UAlberta-EcoCar/Auxiliaries-Board/E-P-099-R3.0.brd

## EAGLE design E-P-099-R3.0.brd (2018-06-12)

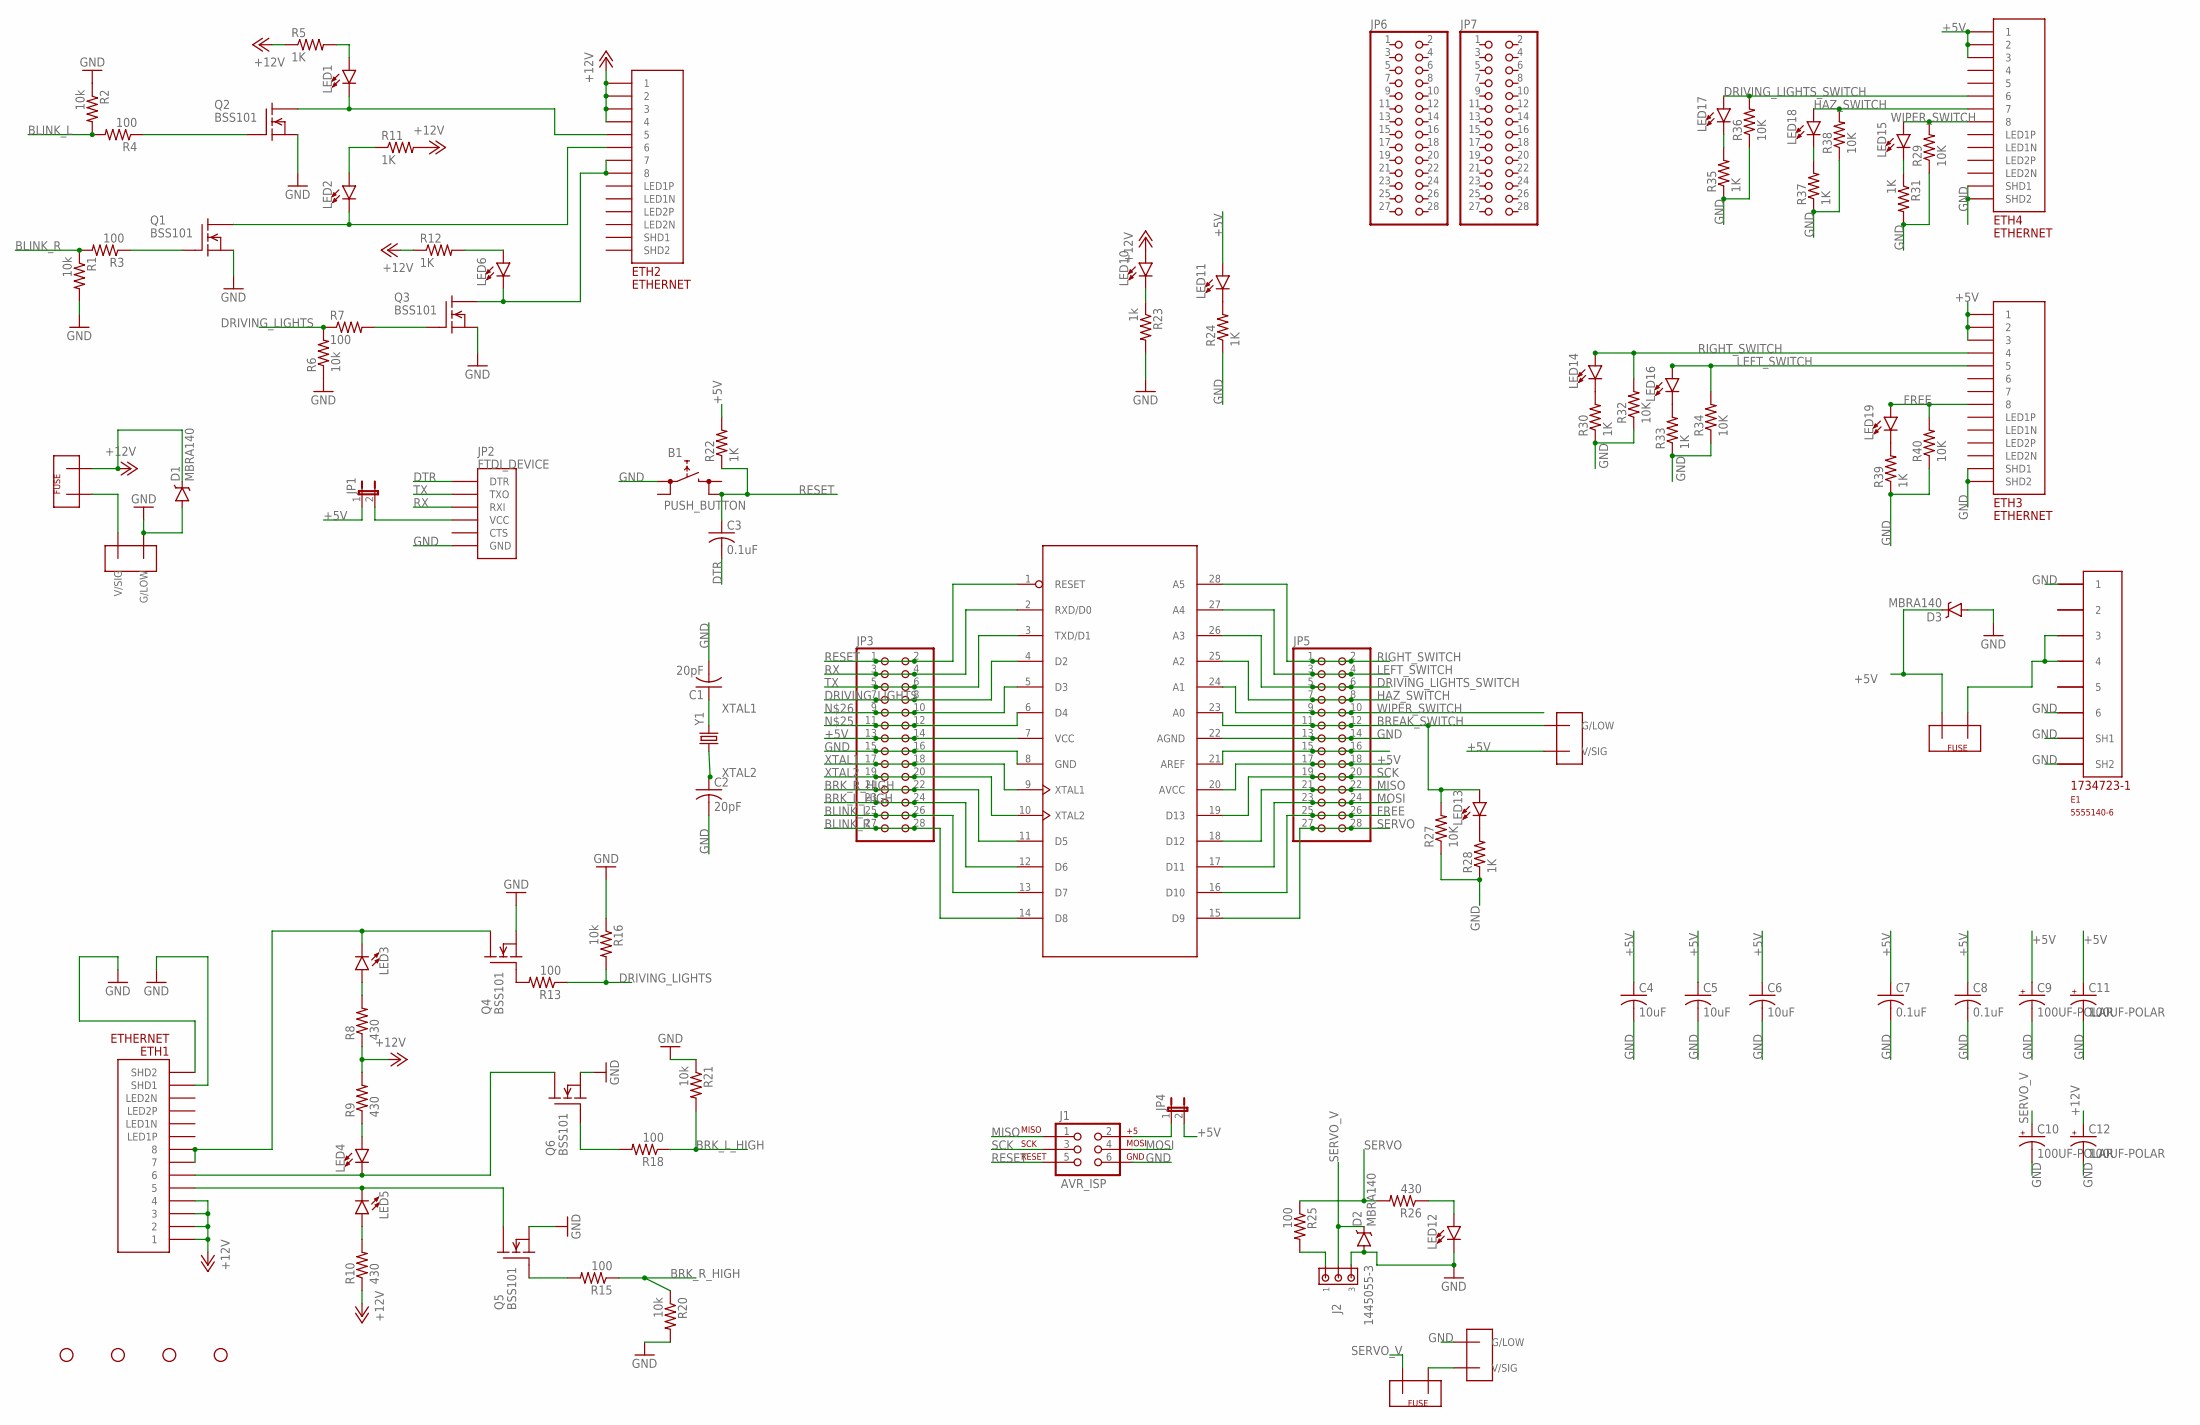
[picture p1: schematic E-P-099-R3.0.sch]

Parts:
AT1: ATMEGA328; DIP28-0.3IN
B1: PUSH_BUTTON; PUSHBUTTON
C1, C2: 20pF; C0805
C3, C7, C8: 0.1uF; C0805
C4, C5, C6: 10uF; C0805
C9, C10, C11, C12: 100UF-POLAR; EEU-FR1H101
D1, D2, D3: MBRA140; SMA-DIODE
E1: 5555140-6; 1734723-1_RJ11
ETH1, ETH2, ETH3, ETH4: ETHERNET; A122645-ND
F1, F2, F3: FUSEMINI-BLADE; MINI-BLADE-FUSE
J1: AVR_ISP; 2X3
J2: 1445055-3
JP1, JP4: JP1E; JP1
JP2: FTDI_DEVICE; FTDI_DEVICE_SIDE
JP3, JP5, JP6, JP7: PINHD-2X14; 2X14
LED1, LED2, LED3, LED4, LED5, LED6, LED10, LED11, LED12, LED13, LED14, LED15, LED16, LED17, LED18, LED19: LED0603; LED-0603
Q1, Q2, Q3, Q4, Q5, Q6: BSS101; TO92
R1, R2, R6, R16, R20, R21: 10k; 0805
R3, R4, R7, R13, R15, R18, R25: 100; 0805
R5, R11, R12, R22, R24, R28, R30, R31, R33, R35, R37, R39: 1K; 0805
R8, R9, R10, R26: 430; 0805
R23: 1k; 0805
R27, R29, R32, R34, R36, R38, R40: 10K; R0805
STANDOFF1, STANDOFF2, STANDOFF3, STANDOFF4: STAND-OFF
TE1, TE3: TE770966; 2X1-MATE-N-LOCK
TE2: SERVO_PWR; 2X1-MATE-N-LOCK
Y1: CRYSTALHC49US; HC49US

Connections:
+5V: AT1.7 (VCC), AT1.20 (AVCC), C4.1, C5.1, C6.1, C7.1, C8.1, C9.P (+), C11.P (+), D3.C, ETH3.P$1 (1), ETH3.P$2 (2), ETH3.P$3 (3), ETH4.P$1 (1), ETH4.P$2 (2), ETH4.P$3 (3), F3.OUT, JP1.1, JP3.13, JP3.14, JP4.2, JP5.17, JP5.18, LED11.A, R22.2, TE3.CIRCUIT1 (V/SIG)
+12V: C12.P (+), D1.C, ETH1.P$1 (1), ETH1.P$2 (2), ETH1.P$3 (3), ETH1.P$4 (4), ETH2.P$1 (1), ETH2.P$2 (2), ETH2.P$3 (3), ETH2.P$4 (4), F1.OUT, LED10.A, R5.1, R8.1, R9.2, R10.1, R11.2, R12.1
BLINK_L: AT1.13 (D7), JP3.25, JP3.26, R2.2, R4.2
BLINK_R: AT1.14 (D8), JP3.27, JP3.28, R1.1, R3.2
BREAK_SWITCH: AT1.23 (A0), JP5.11, JP5.12, LED13.A, R27.2, TE3.CIRCUIT2 (G/LOW)
BRK_L_HIGH: AT1.12 (D6), JP3.23, JP3.24, R18.1, R21.2
BRK_R_HIGH: AT1.11 (D5), JP3.21, JP3.22, R15.1, R20.1
DRIVING_LIGHTS: AT1.4 (D2), JP3.7, JP3.8, R6.2, R7.1, R13.1, R16.2
DRIVING_LIGHTS_SWITCH: AT1.26 (A3), ETH4.P$6 (6), JP5.5, JP5.6, LED17.A, R36.2
DTR: C3.2, JP2.P$1 (DTR)
FREE: AT1.16 (D10), ETH3.P$8 (8), JP5.25, JP5.26, LED19.A, R40.2
GND: AT1.8 (GND), AT1.22 (AGND), B1.L1 (L), C1.2, C2.2, C4.2, C5.2, C6.2, C7.2, C8.2, C9.G (-), C10.G (-), C11.G (-), C12.G (-), D1.A, D2.A, D3.A, E1.1, E1.6, E1.SH1, E1.SH2, ETH1.P$13 (SHD1), ETH1.P$14 (SHD2), ETH3.P$13 (SHD1), ETH3.P$14 (SHD2), ETH4.P$13 (SHD1), ETH4.P$14 (SHD2), J1.6, J2.3, JP2.P$6 (GND), JP3.15, JP3.16, JP5.13, JP5.14, LED12.C, Q1.1 (S), Q2.1 (S), Q3.1 (S), Q4.1 (S), Q5.1 (S), Q6.1 (S), R1.2, R2.1, R6.1, R16.1, R20.2, R21.1, R23.2, R24.1, R27.1, R28.1, R29.1, R30.1, R31.2, R32.1, R33.1, R34.1, R35.1, R36.1, R37.1, R38.1, R39.1, R40.1, TE1.CIRCUIT2 (G/LOW), TE2.CIRCUIT2 (G/LOW)
HAZ_SWITCH: AT1.25 (A2), ETH4.P$7 (7), JP5.7, JP5.8, LED18.A, R38.2
LEFT_SWITCH: AT1.27 (A4), ETH3.P$5 (5), JP5.3, JP5.4, LED16.A, R34.2
MISO: AT1.18 (D12), J1.1, JP5.21, JP5.22
MOSI: AT1.17 (D11), J1.4, JP5.23, JP5.24
unnamed: LED14.C, R30.2
unnamed: LED17.C, R35.2
unnamed: LED16.C, R33.2
unnamed: ETH1.P$7 (7), ETH1.P$8 (8), LED3.C, Q4.3 (D)
unnamed: ETH1.P$6 (6), LED4.C, Q6.3 (D)
unnamed: E1.3, E1.4, F3.IN
unnamed: ETH1.P$5 (5), LED5.C, Q5.3 (D)
unnamed: Q4.2 (G), R13.2
unnamed: JP1.2, JP2.P$4 (VCC)
unnamed: LED19.C, R39.2
unnamed: LED13.C, R28.2
unnamed: LED12.A, R26.1
unnamed: J2.1, R25.2
unnamed: Q5.2 (G), R15.2
unnamed: Q6.2 (G), R18.2
unnamed: LED10.C, R23.1
unnamed: Q2.2 (G), R4.1
unnamed: LED5.A, R10.2
unnamed: LED11.C, R24.2
unnamed: ETH2.P$7 (7), ETH2.P$8 (8), LED6.C, Q3.3 (D)
unnamed: ETH2.P$6 (6), LED2.C, Q1.3 (D)
unnamed: ETH2.P$5 (5), LED1.C, Q2.3 (D)
unnamed: LED4.A, R9.1
unnamed: AT1.6 (D4), JP3.11, JP3.12
unnamed: AT1.5 (D3), JP3.9, JP3.10
unnamed: LED3.A, R8.2
unnamed: LED15.C, R31.1
unnamed: F2.IN, TE2.CIRCUIT1 (V/SIG)
unnamed: LED1.A, R5.2
unnamed: Q1.2 (G), R3.1
unnamed: LED2.A, R11.1
unnamed: Q3.2 (G), R7.2
unnamed: LED6.A, R12.2
unnamed: J1.2, JP4.1
unnamed: LED18.C, R37.2
unnamed: F1.IN, TE1.CIRCUIT1 (V/SIG)
unnamed: AT1.21 (AREF), JP5.15, JP5.16
RESET: AT1.1 (RESET), B1.R2 (R), C3.1, J1.5, JP3.1, JP3.2, R22.1
RIGHT_SWITCH: AT1.28 (A5), ETH3.P$4 (4), JP5.1, JP5.2, LED14.A, R32.2
RX: AT1.2 (RXD/D0), JP2.P$3 (RXI), JP3.3, JP3.4
SCK: AT1.19 (D13), J1.3, JP5.19, JP5.20
SERVO: AT1.15 (D9), JP5.27, JP5.28, R25.1, R26.2
SERVO_V: C10.P (+), D2.C, F2.OUT, J2.2
TX: AT1.3 (TXD/D1), JP2.P$2 (TXO), JP3.5, JP3.6
WIPER_SWITCH: AT1.24 (A1), ETH4.P$8 (8), JP5.9, JP5.10, LED15.A, R29.2
XTAL1: AT1.9 (XTAL1), C1.1, JP3.17, JP3.18, Y1.2
XTAL2: AT1.10 (XTAL2), C2.1, JP3.19, JP3.20, Y1.1

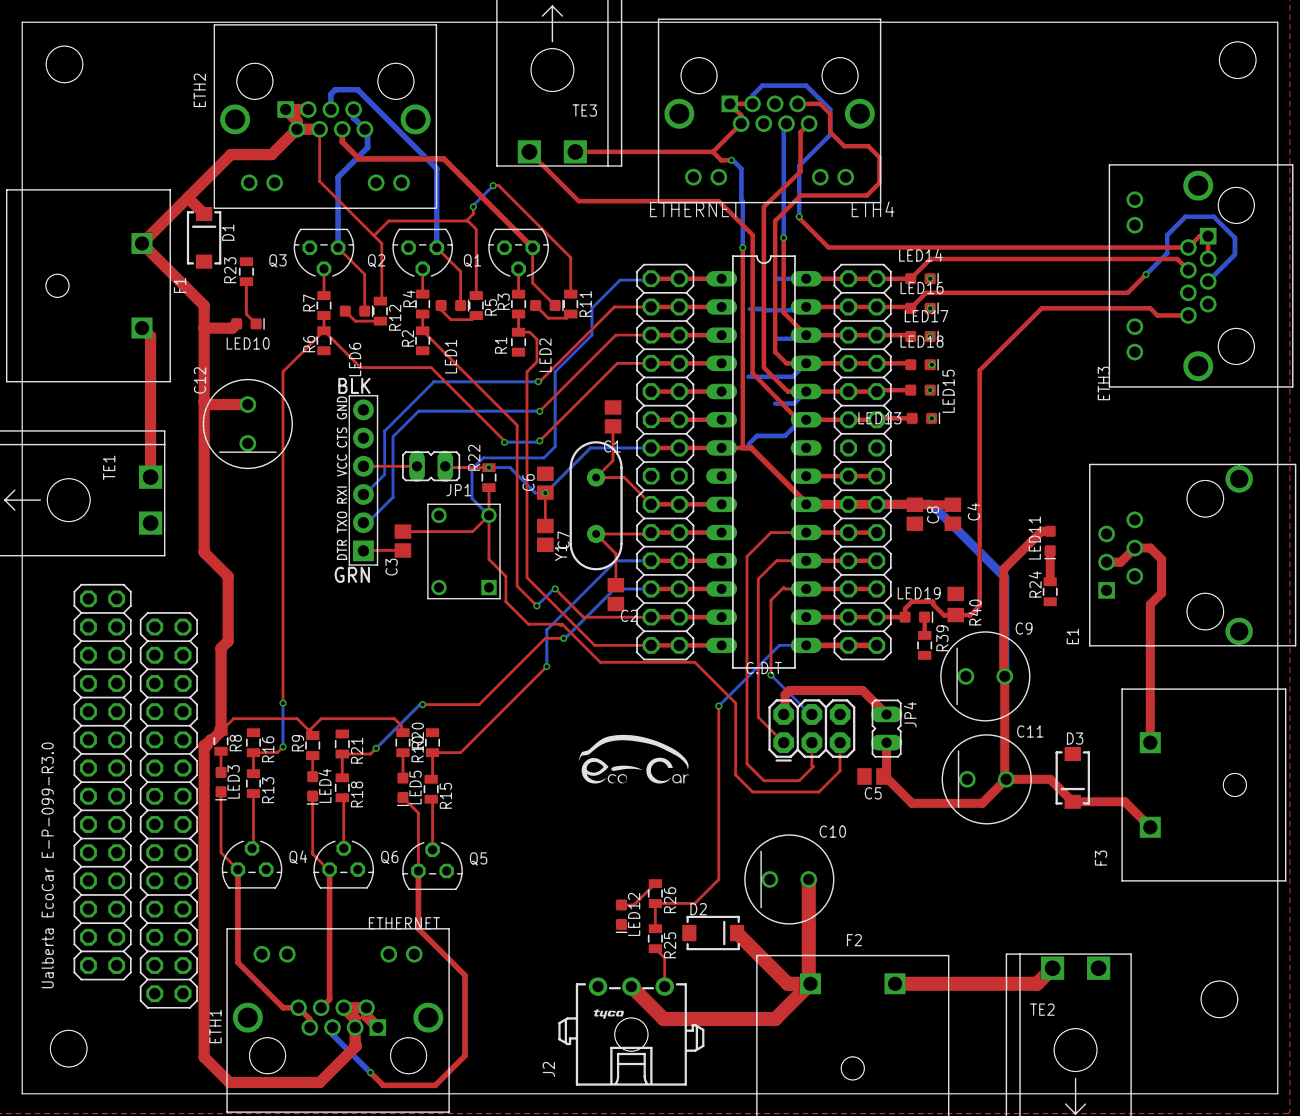
[picture p2: board E-P-099-R3.0.brd from above]

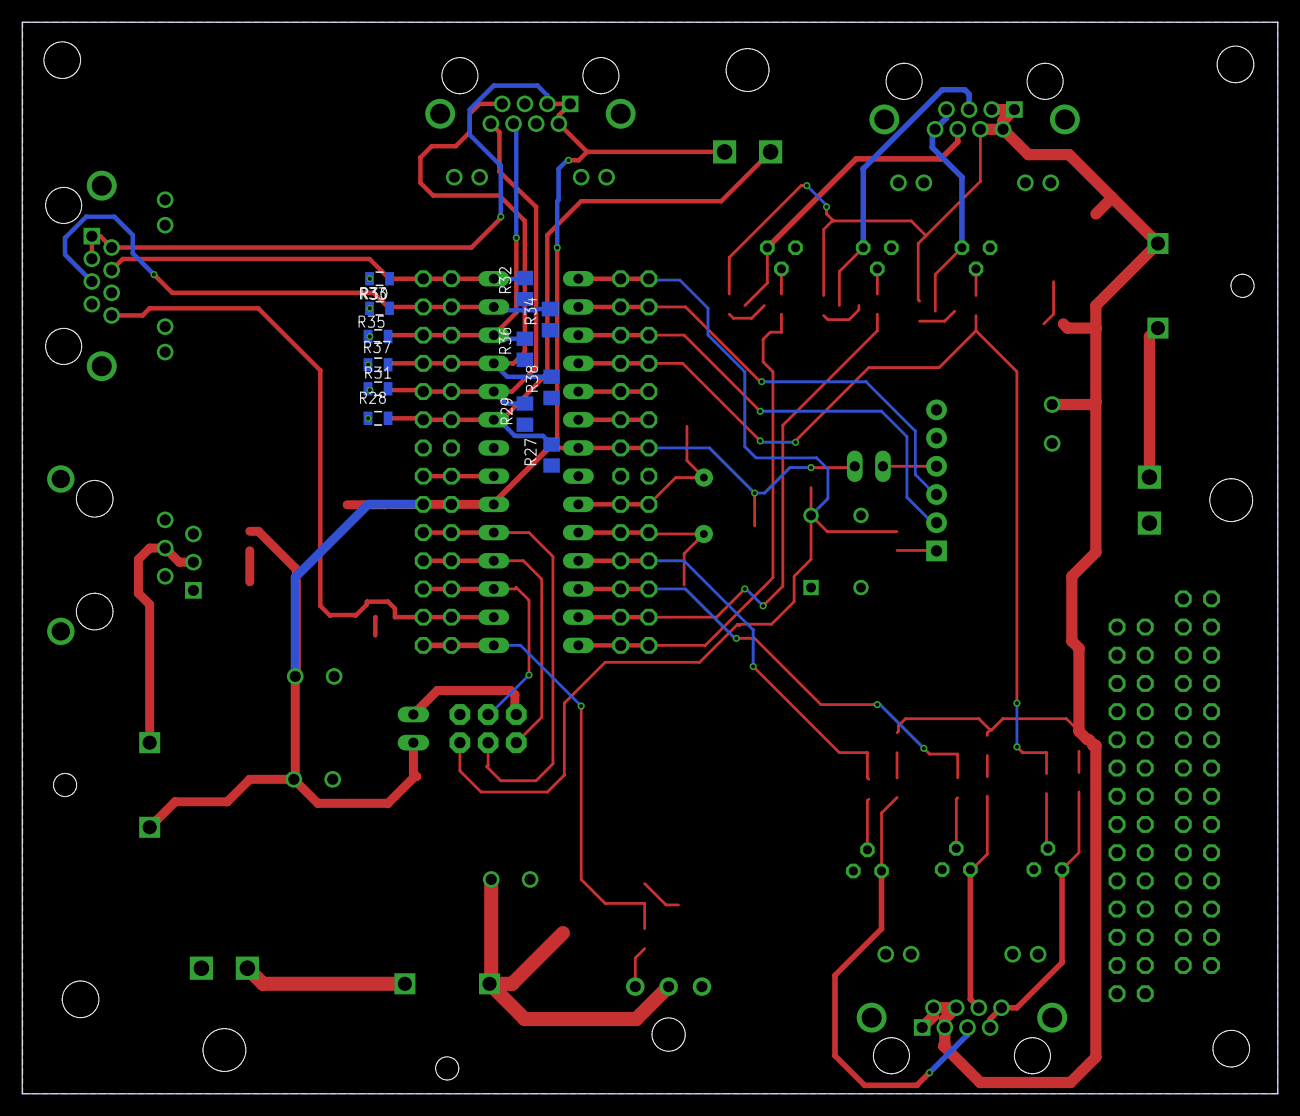
[picture p3: board E-P-099-R3.0.brd from below]

Board: 2 copper layers, 113.1 x 96.5 mm, 101 parts (12 on the bottom side), 63 nets.
