UAlberta-EcoCar/Auxiliaries-Board/Horn Board/Horn Board Rev 1.brd

## EAGLE design Horn Board/Horn Board Rev 1.brd (2017-12-05)

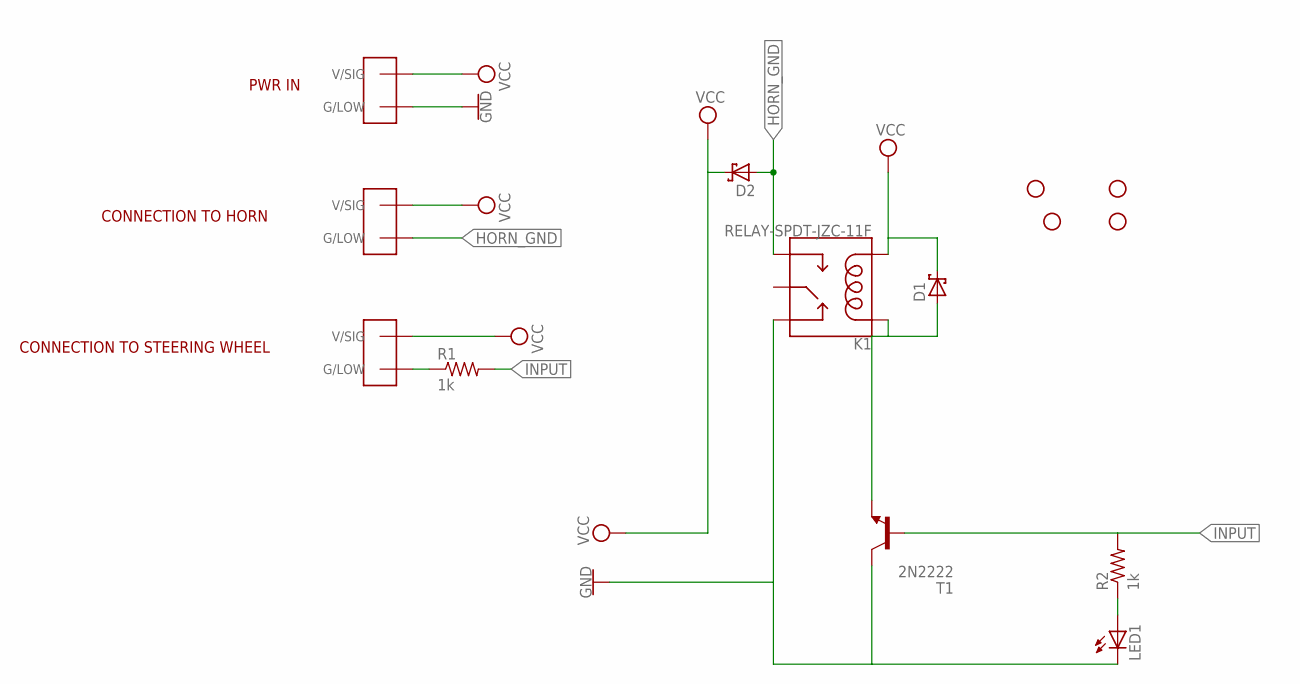
[picture p4: schematic Horn Board Rev 1.sch]

Parts:
D1, D2: SCHOTTKY-DIODEAG; AG
H1, H2, H3, H4: STAND-OFF
K1: RELAY-SPDT-JZC-11F; RELAY-JZC
LED1: LED; SMARTLED-TTW
R1, R2: 1k; 0204V
T1: 2N2222; TO92-EBC-OVAL
U$1, U$2, U$8: TE770966; 2X1-MATE-N-LOCK

Connections:
GND: K1.2 (NC), LED1.C@1 (C), T1.C, U$8.CIRCUIT2 (G/LOW)
HORN_GND: D2.A, K1.3 (NO), U$1.CIRCUIT2 (G/LOW)
INPUT: R1.2, R2.2, T1.B
unnamed: R1.1, U$2.CIRCUIT2 (G/LOW)
unnamed: D1.A, K1.5 (COIL1), T1.E
unnamed: LED1.A@1 (A), R2.1
VCC: D1.C, D2.C, K1.1 (COIL2), U$1.CIRCUIT1 (V/SIG), U$2.CIRCUIT1 (V/SIG), U$8.CIRCUIT1 (V/SIG)

Notes on the sheet:
PWR IN
CONNECTION TO HORN
CONNECTION TO STEERING WHEEL

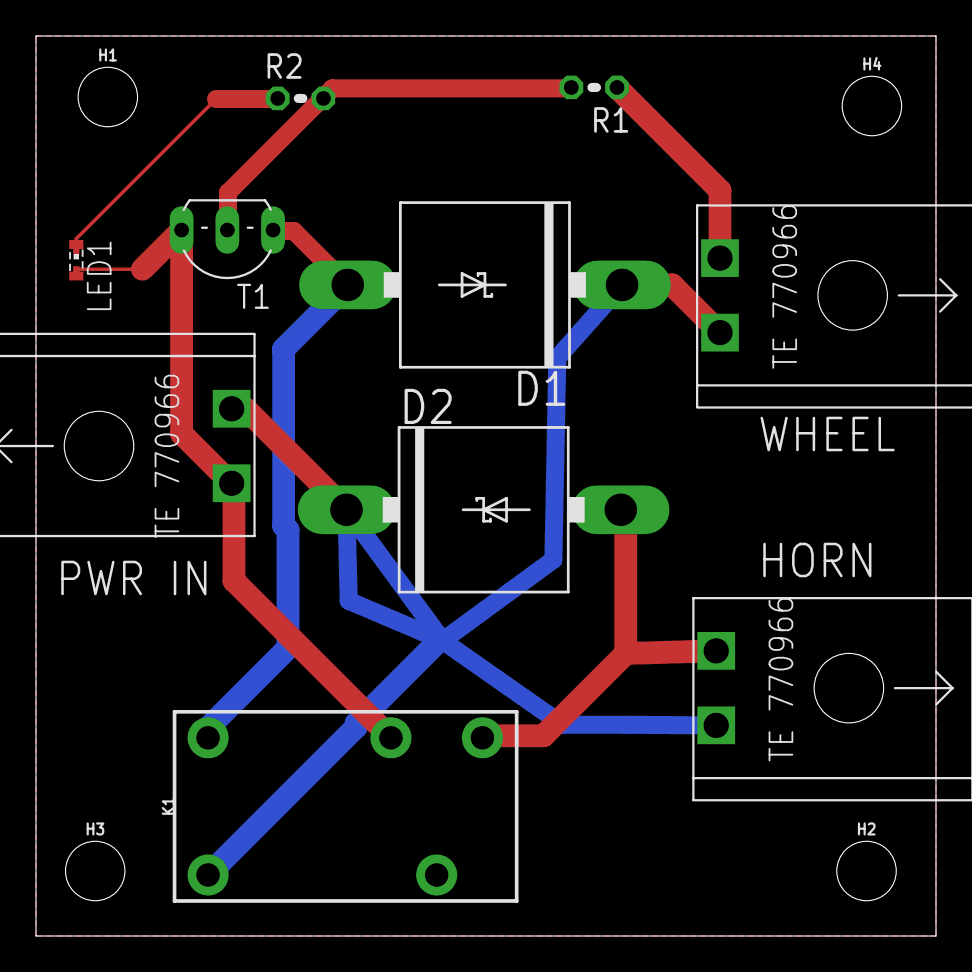
[picture p5: board Horn Board Rev 1.brd from above]

Board: 2 copper layers, 50.0 x 50.0 mm, 14 parts (0 on the bottom side), 7 nets.
