UAlberta-EcoCar/Auxiliaries-Board/E-P-099-R2.7.brd

## EAGLE design E-P-099-R2.7.brd (2017-09-17)

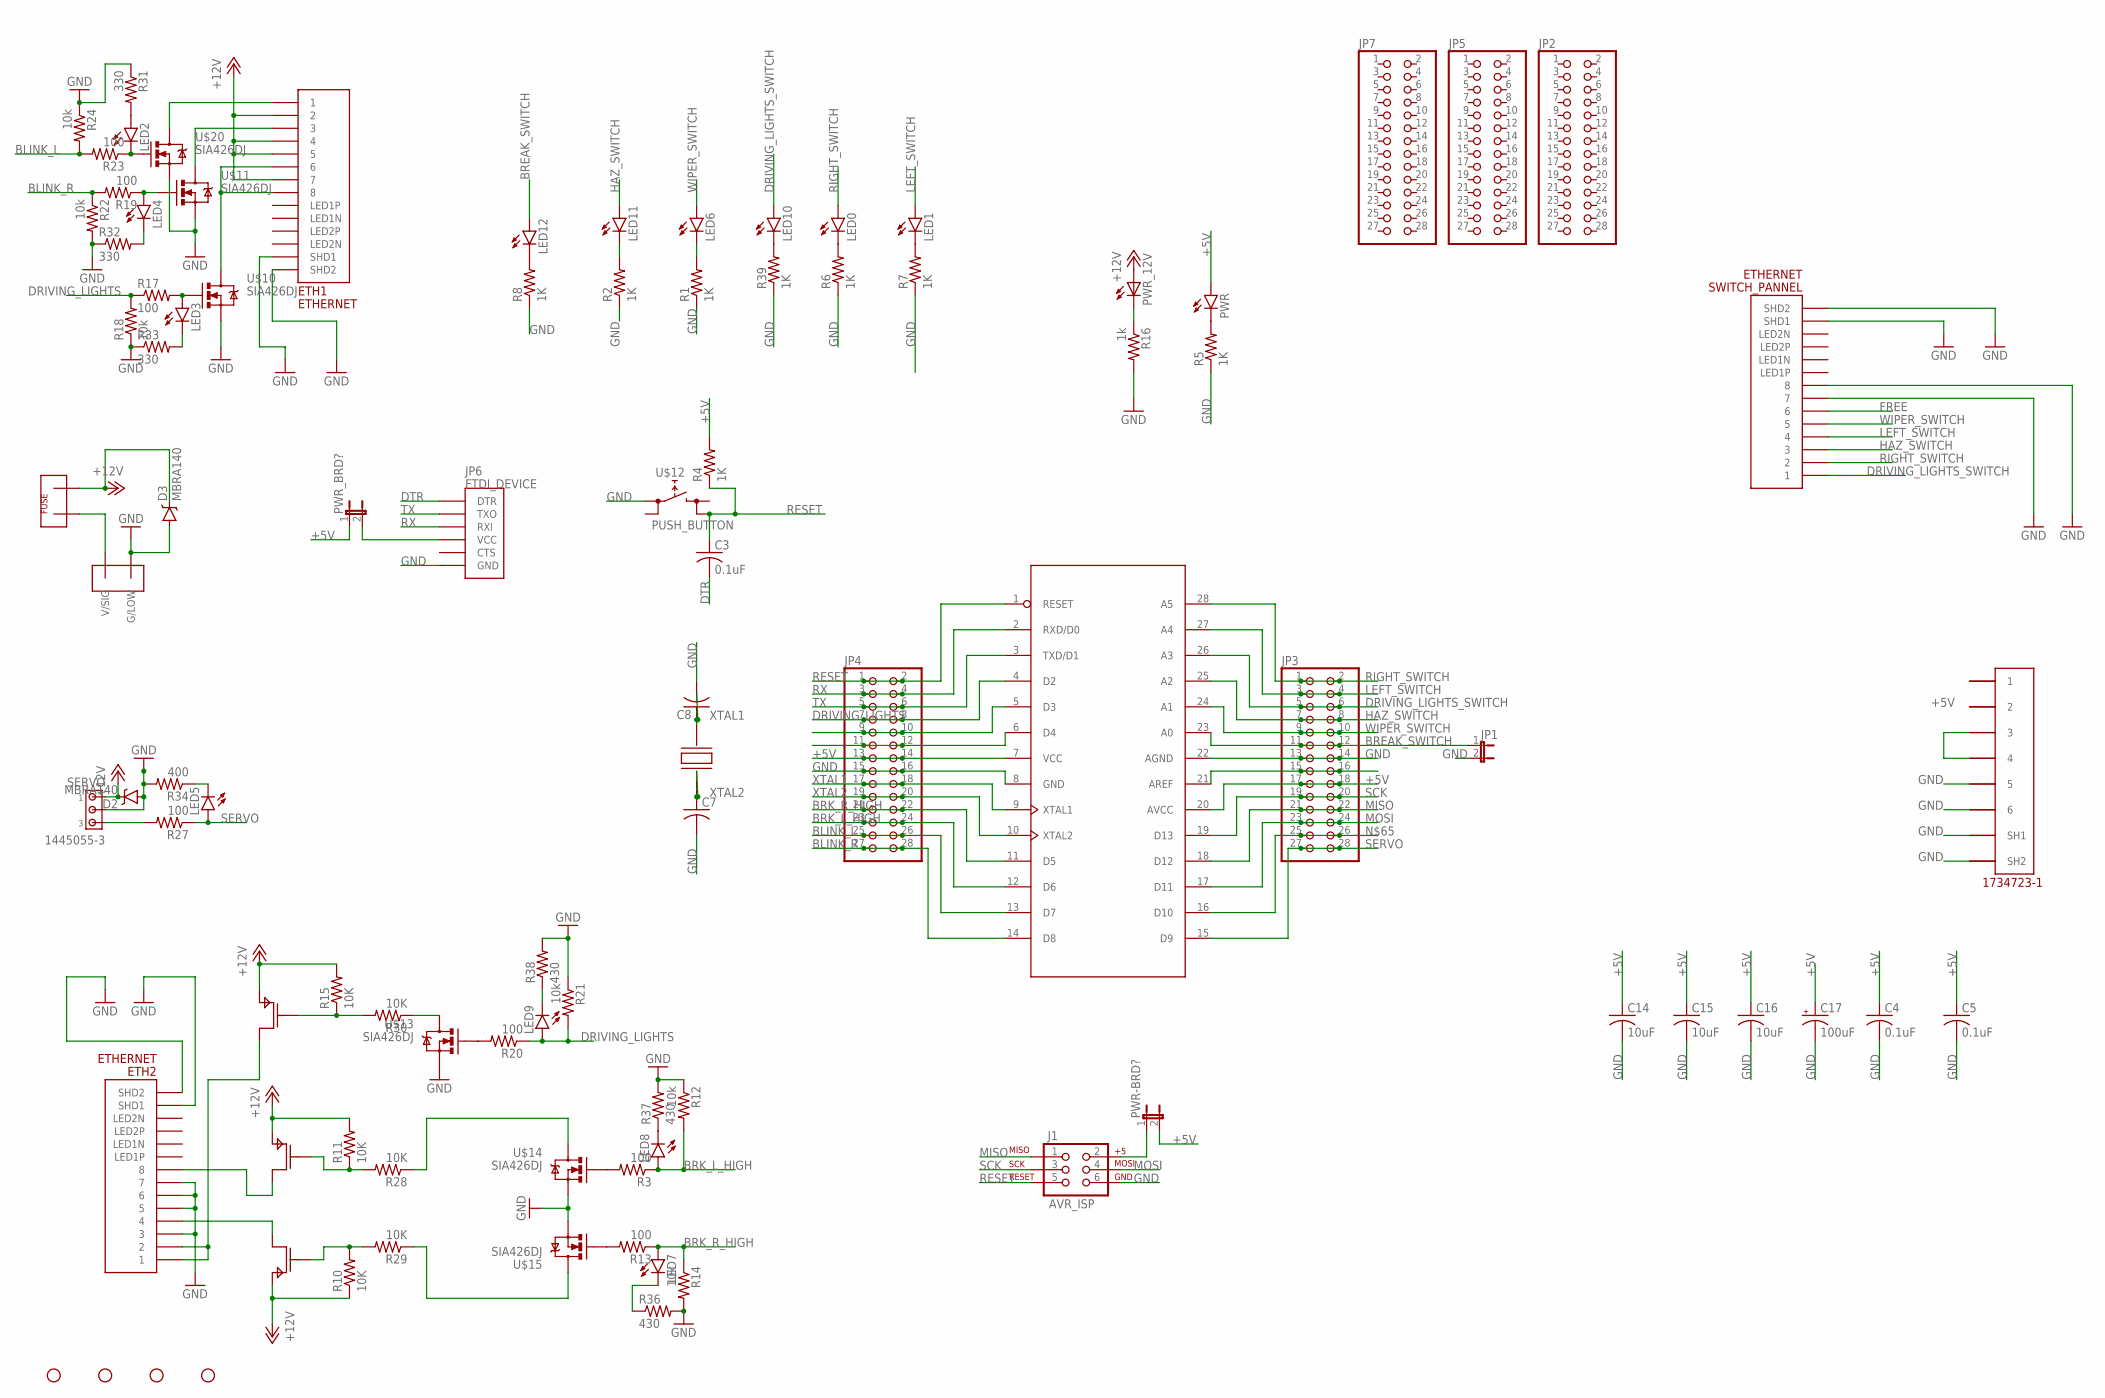
[picture p6: schematic E-P-099-R2.7.sch]

Parts:
5V_IN: 5555140-6; 1734723-1_RJ11
C3, C4, C5: 0.1uF; C0805
C7, C8: C-USC0805; C0805
C14, C15, C16: 10uF; C0805
C17: 100uF; PANASONIC_D
D2, D3: MBRA140; SMA-DIODE
ETH1, ETH2: ETHERNET; A122645-ND
J1: AVR_ISP; 2X3
JP1: JUMPER-2PTH; 1X02
JP2, JP3, JP4, JP5, JP7: PINHD-2X14; 2X14
JP6: FTDI_DEVICE; FTDI_DEVICE_SIDE
LED0, LED1, LED2, LED3, LED4, LED5, LED6, LED7, LED8, LED9, LED10, LED11, LED12: LED0603; LED-0603
PWR: LED0603; LED-0603
PWR-BRD?: JP1E; JP1
PWR_12V: LEDCHIPLED_1206; CHIPLED_1206
PWR_BRD?: JP1E; JP1
R1, R2, R4, R5, R6, R7, R8, R39: 1K; 0805
R3, R13, R17, R19, R20, R23, R27: 100; 0805
R10, R11, R15, R28, R29, R30: 10K; 0805
R12, R14, R18, R21, R22, R24: 10k; 0805
R16: 1k; 0805
R31, R32, R33: 330; 0805
R34: 400; 0805
R36, R37, R38: 430; 0805
SERVO: 1445055-3
STANDOFF1, STANDOFF2, STANDOFF3, STANDOFF4: STAND-OFF
SWITCH_PANNEL: ETHERNET; A122645-ND
U$3, U$5, U$6: SIA449DJ; SIA449DJ-T1-GE3CT-ND
U$4: ATMEGA328; DIP28-0.3IN
U$8: TE770966; 2X1-MATE-N-LOCK
U$9: FUSEMINI-BLADE; MINI-BLADE-FUSE
U$10, U$11, U$13, U$14, U$15, U$20: SIA426DJ; SC70-6L
U$12: PUSH_BUTTON; PUSHBUTTON
U$18: CRYSTAL; 7A_CRYSTAL

Connections:
+5V: 5V_IN.3, 5V_IN.4, C4.1, C5.1, C14.1, C15.1, C16.1, C17.+, JP3.17, JP3.18, JP4.13, JP4.14, PWR.A, PWR-BRD?.2, PWR_BRD?.1, R4.2, U$4.7 (VCC), U$4.20 (AVCC)
+12V: D2.C, D3.C, ETH1.P$2 (2), ETH1.P$4 (4), ETH1.P$5 (5), ETH1.P$7 (7), PWR_12V.A, R10.1, R11.2, R15.2, SERVO.1, U$3.P$4 (P$S), U$3.P$5 (P$S), U$5.P$4 (P$S), U$5.P$5 (P$S), U$6.P$4 (P$S), U$6.P$5 (P$S), U$9.OUT
BLINK_L: JP4.25, JP4.26, R23.2, R24.2, U$4.13 (D7)
BLINK_R: JP4.27, JP4.28, R19.2, R22.1, U$4.14 (D8)
BREAK_SWITCH: JP1.1, JP3.11, JP3.12, LED12.A, U$4.23 (A0)
BRK_L_HIGH: JP4.23, JP4.24, LED8.A, R3.1, R12.2, U$4.12 (D6)
BRK_R_HIGH: JP4.21, JP4.22, LED7.A, R13.1, R14.1, U$4.11 (D5)
DRIVING_LIGHTS: JP4.7, JP4.8, LED9.A, R17.1, R18.2, R20.1, R21.2, U$4.4 (D2)
DRIVING_LIGHTS_SWITCH: JP3.5, JP3.6, LED10.A, SWITCH_PANNEL.P$1 (1), U$4.26 (A3)
DTR: C3.2, JP6.P$1 (DTR)
FREE: SWITCH_PANNEL.P$6 (6)
GND: 5V_IN.5, 5V_IN.6, 5V_IN.SH1, 5V_IN.SH2, C4.2, C5.2, C7.2, C8.2, C14.2, C15.2, C16.2, C17.-, D2.A, D3.A, ETH1.P$13 (SHD1), ETH1.P$14 (SHD2), ETH2.P$3 (3), ETH2.P$5 (5), ETH2.P$6 (6), ETH2.P$7 (7), ETH2.P$13 (SHD1), ETH2.P$14 (SHD2), J1.6, JP1.2, JP3.13, JP3.14, JP4.15, JP4.16, JP6.P$6 (GND), R1.1, R2.1, R5.1, R6.1, R7.1, R8.1, R12.1, R14.2, R16.2, R18.1, R21.1, R22.2, R24.1, R31.1, R32.1, R33.1, R34.2, R36.2, R37.2, R38.2, R39.1, SERVO.2, SWITCH_PANNEL.P$7 (7), SWITCH_PANNEL.P$8 (8), SWITCH_PANNEL.P$13 (SHD1), SWITCH_PANNEL.P$14 (SHD2), U$4.8 (GND), U$4.22 (AGND), U$8.CIRCUIT2 (G/LOW), U$10.S@0 (S), U$10.S@1 (S), U$11.S@0 (S), U$11.S@1 (S), U$12.L1 (L), U$13.S@0 (S), U$13.S@1 (S), U$14.S@0 (S), U$14.S@1 (S), U$15.S@0 (S), U$15.S@1 (S), U$20.S@0 (S), U$20.S@1 (S)
HAZ_SWITCH: JP3.7, JP3.8, LED11.A, SWITCH_PANNEL.P$3 (3), U$4.25 (A2)
LEFT_SWITCH: JP3.3, JP3.4, LED1.A, SWITCH_PANNEL.P$4 (4), U$4.27 (A4)
MISO: J1.1, JP3.21, JP3.22, U$4.18 (D12)
MOSI: J1.4, JP3.23, JP3.24, U$4.17 (D11)
unnamed: LED12.C, R8.2
unnamed: LED6.C, R1.2
unnamed: LED11.C, R2.2
unnamed: ETH2.P$4 (4), U$6.P$1 (P$D)
unnamed: ETH2.P$8 (8), U$5.P$1 (P$D)
unnamed: R13.2, U$15.G
unnamed: R20.2, U$13.G
unnamed: JP6.P$4 (VCC), PWR_BRD?.2
unnamed: LED0.C, R6.2
unnamed: LED1.C, R7.2
unnamed: ETH2.P$1 (1), ETH2.P$2 (2), U$3.P$1 (P$D)
unnamed: R11.1, R28.2, U$5.P$6 (P$G)
unnamed: PWR_12V.C, R16.1
unnamed: LED2.C, R23.1, U$20.G
unnamed: PWR.C, R5.2
unnamed: ETH1.P$1 (1), U$20.D
unnamed: R3.2, U$14.G
unnamed: R15.1, R30.2, U$3.P$6 (P$G)
unnamed: ETH1.P$3 (3), U$11.D
unnamed: JP4.11, JP4.12, U$4.6 (D4)
unnamed: JP4.9, JP4.10, U$4.5 (D3)
unnamed: ETH1.P$6 (6), ETH1.P$8 (8), U$10.D
unnamed: LED4.C, R32.2
unnamed: R10.2, R29.2, U$6.P$6 (P$G)
unnamed: LED4.A, R19.1, U$11.G
unnamed: R30.1, U$13.D
unnamed: LED3.A, R17.2, U$10.G
unnamed: R27.2, SERVO.3
unnamed: J1.2, PWR-BRD?.1
unnamed: LED3.C, R33.2
unnamed: LED5.C, R34.1
unnamed: LED7.C, R36.1
unnamed: LED8.C, R37.1
unnamed: R28.1, U$14.D
unnamed: LED9.C, R38.1
unnamed: R29.1, U$15.D
unnamed: LED10.C, R39.2
unnamed: U$8.CIRCUIT1 (V/SIG), U$9.IN
unnamed: LED2.A, R31.2
unnamed: JP3.15, JP3.16, U$4.21 (AREF)
unnamed: JP3.25, JP3.26, U$4.16 (D10)
RESET: C3.1, J1.5, JP4.1, JP4.2, R4.1, U$4.1 (RESET), U$12.R2 (R)
RIGHT_SWITCH: JP3.1, JP3.2, LED0.A, SWITCH_PANNEL.P$2 (2), U$4.28 (A5)
RX: JP4.3, JP4.4, JP6.P$3 (RXI), U$4.2 (RXD/D0)
SCK: J1.3, JP3.19, JP3.20, U$4.19 (D13)
SERVO: JP3.27, JP3.28, LED5.A, R27.1, U$4.15 (D9)
TX: JP4.5, JP4.6, JP6.P$2 (TXO), U$4.3 (TXD/D1)
WIPER_SWITCH: JP3.9, JP3.10, LED6.A, SWITCH_PANNEL.P$5 (5), U$4.24 (A1)
XTAL1: C8.1, JP4.17, JP4.18, U$4.9 (XTAL1), U$18.P$2
XTAL2: C7.1, JP4.19, JP4.20, U$4.10 (XTAL2), U$18.P$1

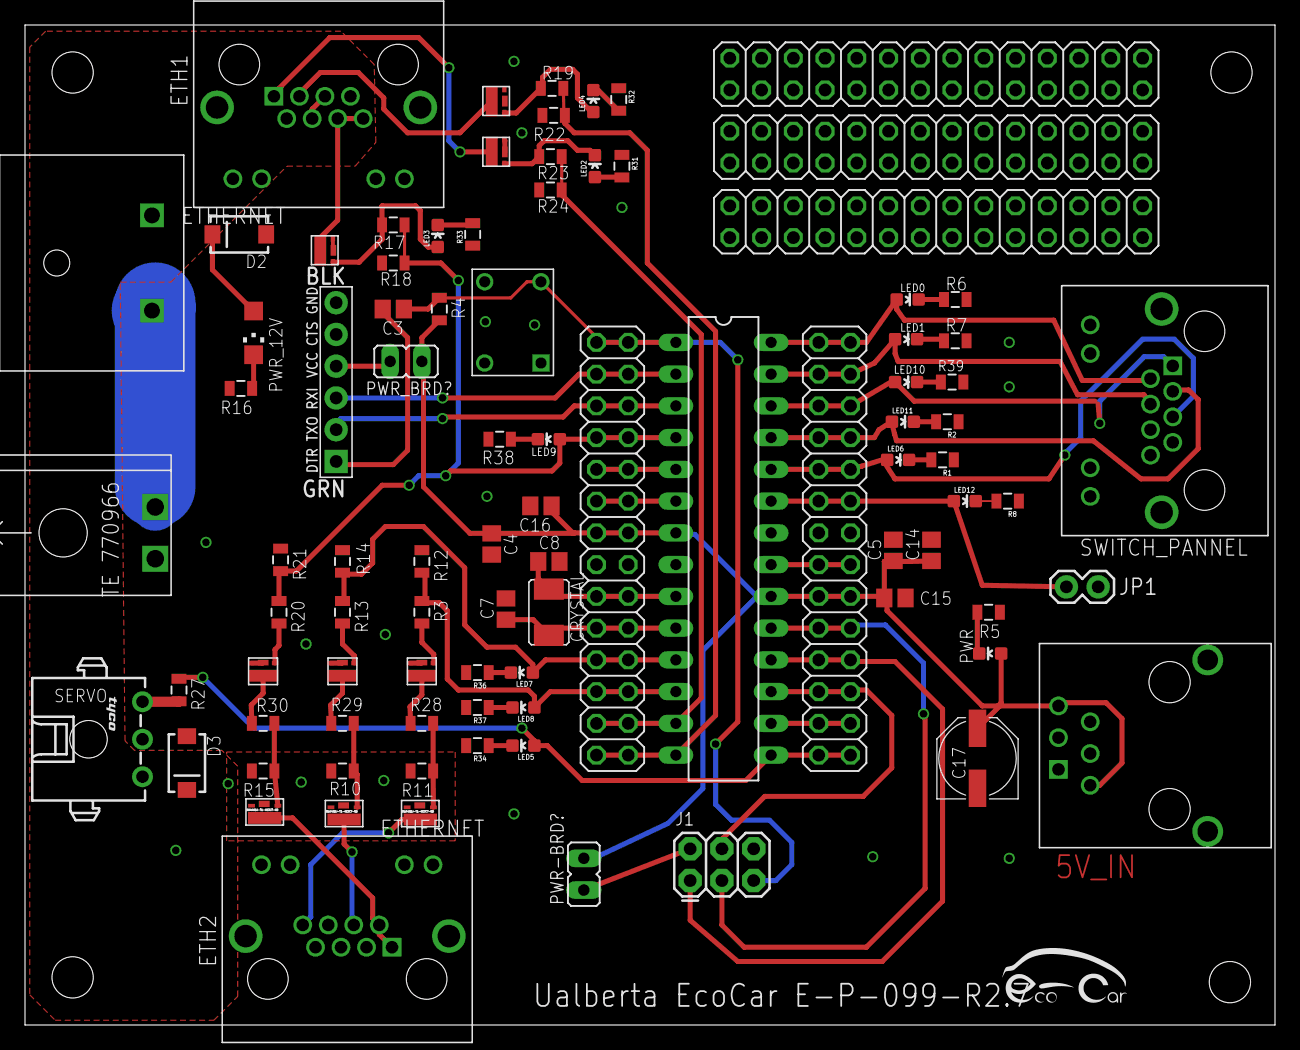
[picture p7: board E-P-099-R2.7.brd from above]

Board: 2 copper layers, 100.0 x 80.0 mm, 94 parts (0 on the bottom side), 65 nets.
