UAlberta-EcoCar/Auxiliaries-Board/Cable Adaptor/connector.brd

## EAGLE design Cable Adaptor/connector.brd (2017-01-29)

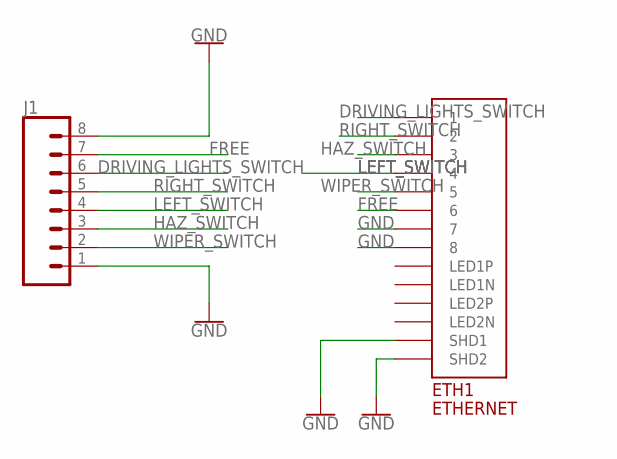
[picture p8: schematic connector.sch]

Parts:
ETH1: ETHERNET; A122645-ND
J1: CONN_08FEMALE_LOCK; 1X08_FEMALE_LOCK

Connections:
DRIVING_LIGHTS_SWITCH: ETH1.P$1 (1), J1.6
FREE: ETH1.P$6 (6), J1.7
GND: ETH1.P$7 (7), ETH1.P$8 (8), ETH1.P$13 (SHD1), ETH1.P$14 (SHD2), J1.1, J1.8
HAZ_SWITCH: ETH1.P$3 (3), J1.3
LEFT_SWITCH: ETH1.P$4 (4), J1.4
RIGHT_SWITCH: ETH1.P$2 (2), J1.5
WIPER_SWITCH: ETH1.P$5 (5), J1.2

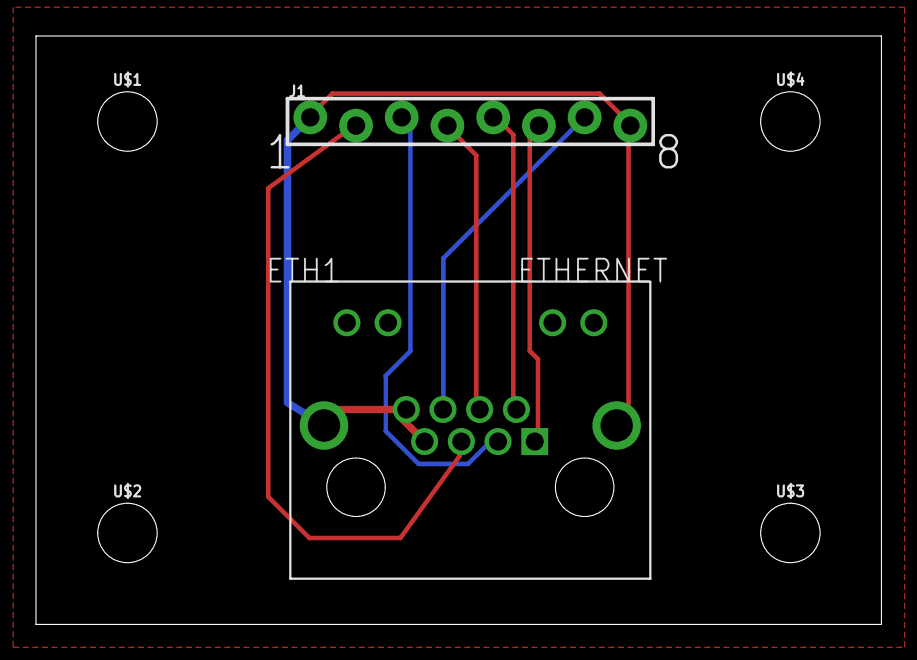
[picture p9: board connector.brd from above]

Board: 2 copper layers, 47.0 x 32.7 mm, 6 parts (0 on the bottom side), 7 nets.

Other parts of the board:
U$1, U$2, U$3, U$4: STAND-OFF
