UAlberta-EcoCar/Auxiliaries-Board/E-P-099-R2.5.brd

## EAGLE design E-P-099-R2.5.brd (2016-12-02)

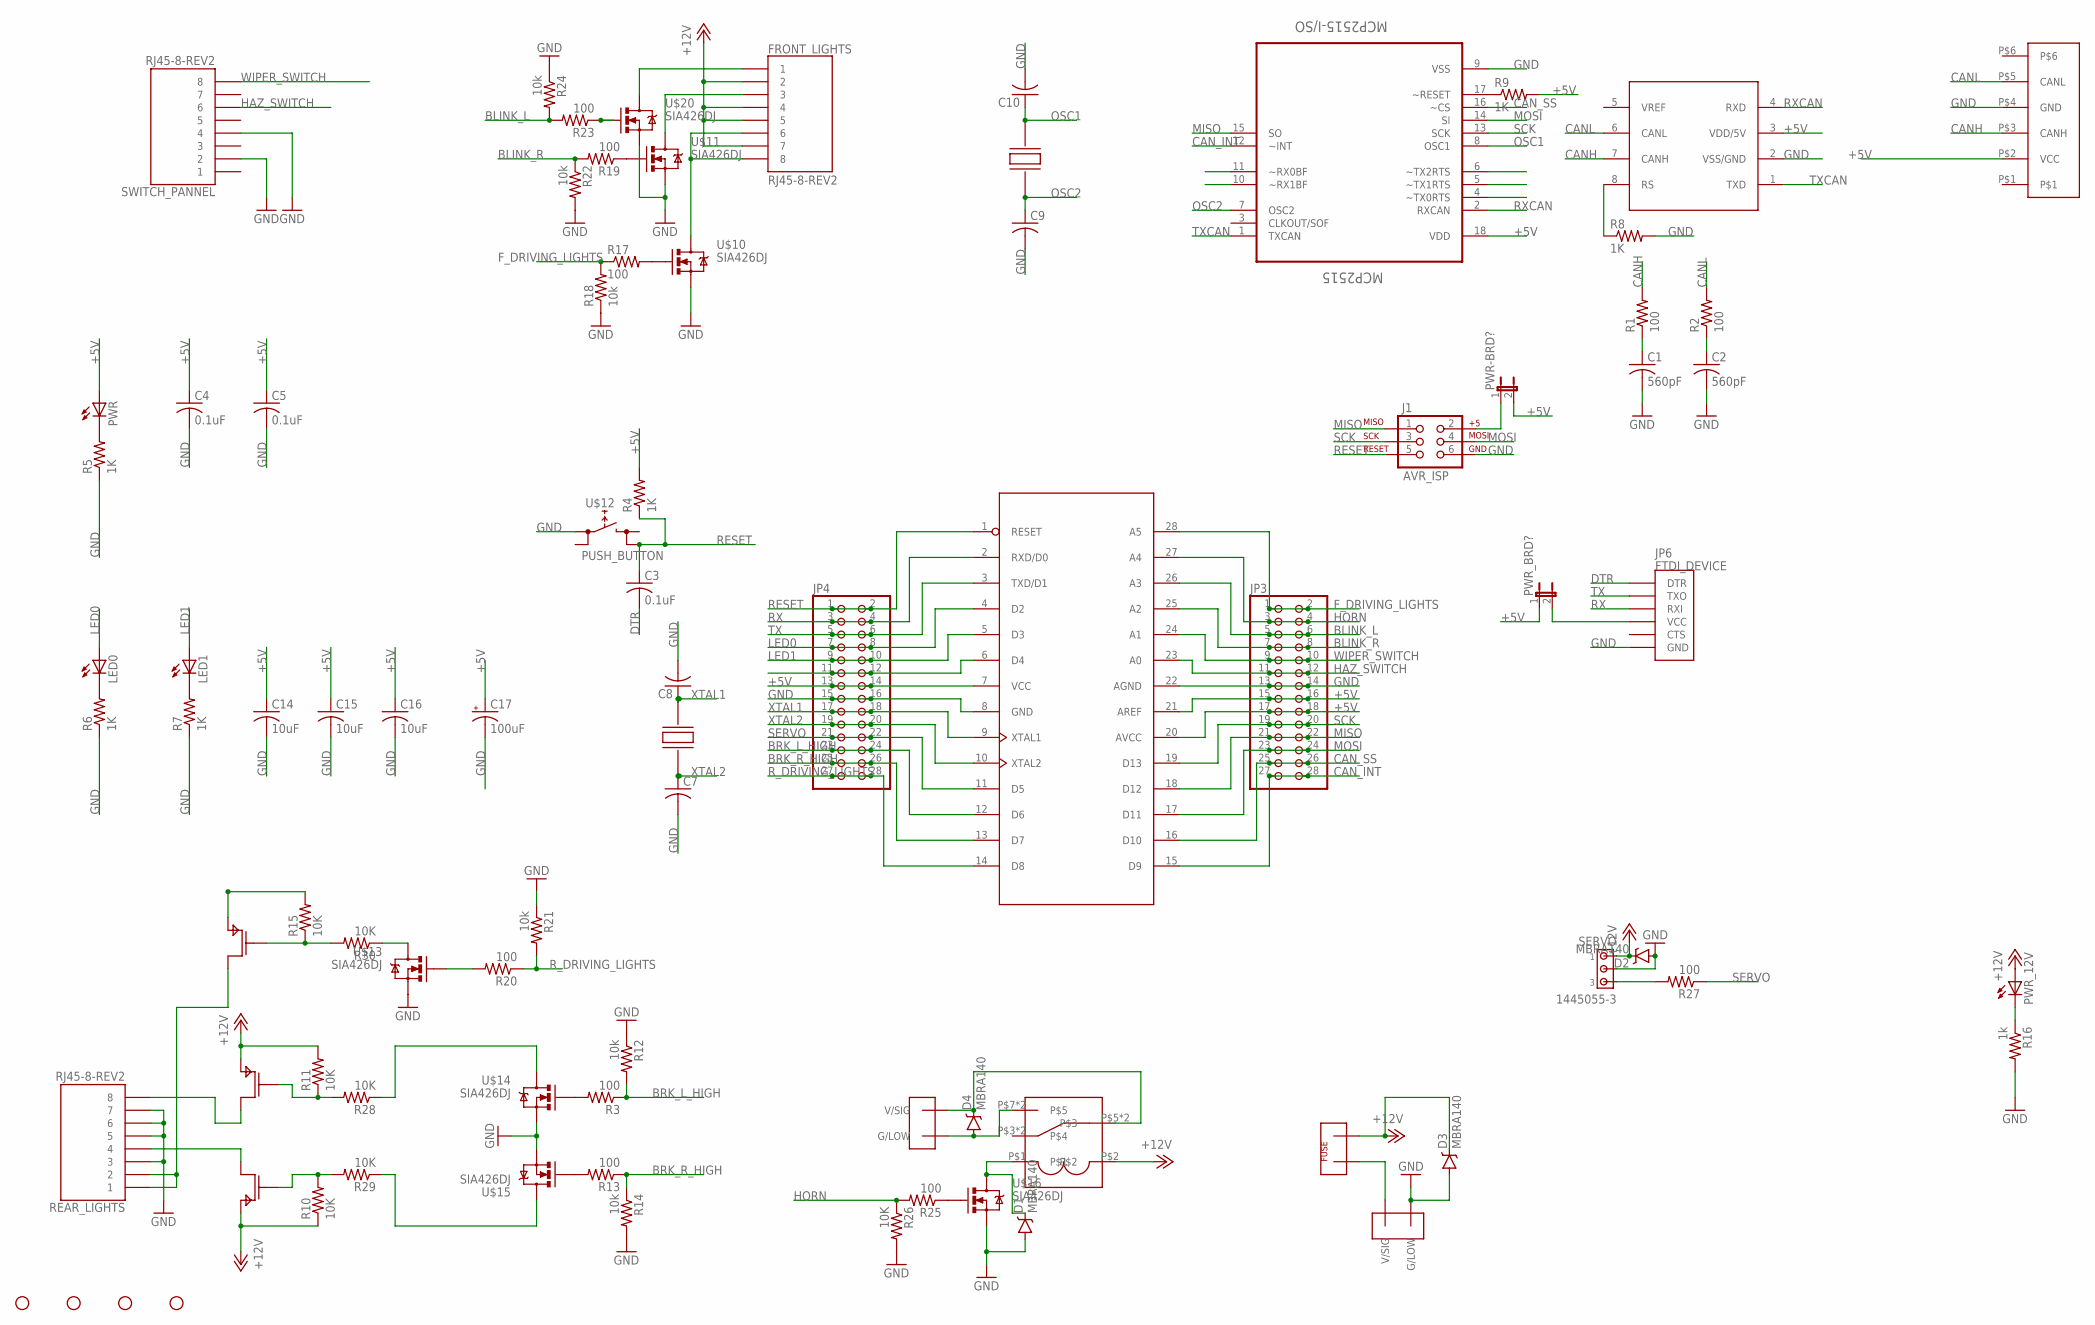
[picture p10: schematic E-P-099-R2.5.sch]

Parts:
C1, C2: 560pF; C0805
C3, C4, C5: 0.1uF; C0805
C7, C8, C9, C10: C-USC0805; C0805
C14, C15, C16: 10uF; C0805
C17: 100uF; PANASONIC_D
CAN-BUS: CAN_6P6C
D1, D2, D3, D4: MBRA140; SMA-DIODE
FRONT_LIGHTS: RJ45-8-REV2; RJ45-8
HORN: TE770966; 2X1-MATE-N-LOCK
J1: AVR_ISP; 2X3
JP3, JP4: PINHD-2X14; 2X14
JP6: FTDI_DEVICE; FTDI_DEVICE_SIDE
LED0, LED1: LED1206; LED-1206
MCP2515: MCP2515-I/SO; SOIC127P1034X264-18N
PWR: LED1206; LED-1206
PWR-BRD?: JP1E; JP1
PWR_12V: LEDCHIPLED_1206; CHIPLED_1206
PWR_BRD?: JP1E; JP1
R1, R2, R3, R13, R17, R19, R20, R23, R25, R27: 100; M0805
R4, R5, R6, R7, R8, R9: 1K; M0805
R10, R11, R15, R26, R28, R29, R30: 10K; M0805
R12, R14, R18, R21, R22, R24: 10k; M0805
R16: 1k; M0805
REAR_LIGHTS: RJ45-8-REV2; RJ45-8
SERVO: 1445055-3
STANDOFF1, STANDOFF2, STANDOFF3, STANDOFF4: STAND-OFF
SWITCH_PANNEL: RJ45-8-REV2; RJ45-8
U$2: MCP2551DIP; DIP8
U$3, U$5, U$6: SIA449DJ; SIA449DJ-T1-GE3CT-ND
U$4: ATMEGA328; DIP28-0.3IN
U$7: RELAY; RTD34012
U$8: TE770966; 2X1-MATE-N-LOCK
U$9: FUSEMINI-BLADE; MINI-BLADE-FUSE
U$10, U$11, U$13, U$14, U$15, U$16, U$20: SIA426DJ; SC70-6L
U$12: PUSH_BUTTON; PUSHBUTTON
U$18, U$19: CRYSTAL; 7A_CRYSTAL

Connections:
+5V: C4.1, C5.1, C14.1, C15.1, C16.1, C17.+, CAN-BUS.P$2 (VCC), JP3.15, JP3.16, JP3.17, JP3.18, JP4.13, JP4.14, MCP2515.18 (VDD), PWR.A, PWR-BRD?.2, PWR_BRD?.1, R4.2, R9.2, U$2.3 (VDD/5V), U$4.7 (VCC), U$4.20 (AVCC), U$4.21 (AREF)
+12V: D2.C, D3.C, FRONT_LIGHTS.2, FRONT_LIGHTS.4, FRONT_LIGHTS.5, FRONT_LIGHTS.7, PWR_12V.A, R10.1, R11.2, R15.2, SERVO.1, U$3.P$4 (P$S), U$3.P$5 (P$S), U$5.P$4 (P$S), U$5.P$5 (P$S), U$6.P$4 (P$S), U$6.P$5 (P$S), U$7.P$2, U$9.OUT
BLINK_L: JP3.5, JP3.6, R23.2, R24.2, U$4.26 (A3)
BLINK_R: JP3.7, JP3.8, R19.2, R22.1, U$4.25 (A2)
BRK_L_HIGH: JP4.23, JP4.24, R3.1, R12.2, U$4.12 (D6)
BRK_R_HIGH: JP4.25, JP4.26, R13.1, R14.1, U$4.13 (D7)
CANH: CAN-BUS.P$3 (CANH), R1.2, U$2.7 (CANH)
CANL: CAN-BUS.P$5 (CANL), R2.2, U$2.6 (CANL)
CAN_INT: JP3.27, JP3.28, MCP2515.12 (~INT), U$4.15 (D9)
CAN_SS: JP3.25, JP3.26, MCP2515.16 (~CS), U$4.16 (D10)
DTR: C3.2, JP6.P$1 (DTR)
F_DRIVING_LIGHTS: JP3.1, JP3.2, R17.1, R18.2, U$4.28 (A5)
GND: C1.2, C2.2, C4.2, C5.2, C7.2, C8.2, C9.2, C10.2, C14.2, C15.2, C16.2, C17.-, CAN-BUS.P$4 (GND), D1.A, D2.A, D3.A, J1.6, JP3.13, JP3.14, JP4.15, JP4.16, JP6.P$6 (GND), MCP2515.9 (VSS), R5.1, R6.1, R7.1, R8.2, R12.1, R14.2, R16.2, R18.1, R21.1, R22.2, R24.1, R26.2, REAR_LIGHTS.3, REAR_LIGHTS.5, REAR_LIGHTS.6, REAR_LIGHTS.7, SERVO.2, SWITCH_PANNEL.2, SWITCH_PANNEL.4, U$2.2 (VSS/GND), U$4.8 (GND), U$4.22 (AGND), U$8.CIRCUIT2 (G/LOW), U$10.S@0 (S), U$10.S@1 (S), U$11.S@0 (S), U$11.S@1 (S), U$12.L1 (L), U$13.S@0 (S), U$13.S@1 (S), U$14.S@0 (S), U$14.S@1 (S), U$15.S@0 (S), U$15.S@1 (S), U$16.S@0 (S), U$16.S@1 (S), U$20.S@0 (S), U$20.S@1 (S)
HAZ_SWITCH: JP3.11, JP3.12, SWITCH_PANNEL.6, U$4.23 (A0)
HORN: JP3.3, JP3.4, R25.2, R26.1, U$4.27 (A4)
LED0: JP4.7, JP4.8, LED0.A, U$4.4 (D2)
LED1: JP4.9, JP4.10, LED1.A, U$4.5 (D3)
MISO: J1.1, JP3.21, JP3.22, MCP2515.15 (SO), U$4.18 (D12)
MOSI: J1.4, JP3.23, JP3.24, MCP2515.14 (SI), U$4.17 (D11)
unnamed: REAR_LIGHTS.4, U$6.P$1 (P$D)
unnamed: REAR_LIGHTS.8, U$5.P$1 (P$D)
unnamed: R13.2, U$15.G
unnamed: R20.2, U$13.G
unnamed: JP6.P$4 (VCC), PWR_BRD?.2
unnamed: LED0.C, R6.2
unnamed: LED1.C, R7.2
unnamed: R8.1, U$2.8 (RS)
unnamed: REAR_LIGHTS.1, REAR_LIGHTS.2, U$3.P$1 (P$D)
unnamed: R11.1, R28.2, U$5.P$6 (P$G)
unnamed: MCP2515.17 (~RESET), R9.1
unnamed: PWR_12V.C, R16.1
unnamed: R23.1, U$20.G
unnamed: D4.C, HORN.CIRCUIT1 (V/SIG), U$7.P$5, U$7.P$6
unnamed: PWR.C, R5.2
unnamed: FRONT_LIGHTS.1, U$20.D
unnamed: R3.2, U$14.G
unnamed: R15.1, R30.2, U$3.P$6 (P$G)
unnamed: FRONT_LIGHTS.3, U$11.D
unnamed: C1.1, R1.1
unnamed: C2.1, R2.1
unnamed: FRONT_LIGHTS.6, FRONT_LIGHTS.8, U$10.D
unnamed: D4.A, HORN.CIRCUIT2 (G/LOW), U$7.P$7, U$7.P$8
unnamed: R25.1, U$16.G
unnamed: D1.C, U$7.P$1, U$16.D
unnamed: R10.2, R29.2, U$6.P$6 (P$G)
unnamed: R19.1, U$11.G
unnamed: R30.1, U$13.D
unnamed: R17.2, U$10.G
unnamed: R27.2, SERVO.3
unnamed: J1.2, PWR-BRD?.1
unnamed: JP4.11, JP4.12, U$4.6 (D4)
unnamed: R28.1, U$14.D
unnamed: R29.1, U$15.D
unnamed: U$8.CIRCUIT1 (V/SIG), U$9.IN
OSC1: C10.1, MCP2515.8 (OSC1), U$19.P$2
OSC2: C9.1, MCP2515.7 (OSC2), U$19.P$1
RESET: C3.1, J1.5, JP4.1, JP4.2, R4.1, U$4.1 (RESET), U$12.R2 (R)
RX: JP4.3, JP4.4, JP6.P$3 (RXI), U$4.2 (RXD/D0)
RXCAN: MCP2515.2 (RXCAN), U$2.4 (RXD)
R_DRIVING_LIGHTS: JP4.27, JP4.28, R20.1, R21.2, U$4.14 (D8)
SCK: J1.3, JP3.19, JP3.20, MCP2515.13 (SCK), U$4.19 (D13)
SERVO: JP4.21, JP4.22, R27.1, U$4.11 (D5)
TX: JP4.5, JP4.6, JP6.P$2 (TXO), U$4.3 (TXD/D1)
TXCAN: MCP2515.1 (TXCAN), U$2.1 (TXD)
WIPER_SWITCH: JP3.9, JP3.10, SWITCH_PANNEL.8, U$4.24 (A1)
XTAL1: C8.1, JP4.17, JP4.18, U$4.9 (XTAL1), U$18.P$2
XTAL2: C7.1, JP4.19, JP4.20, U$4.10 (XTAL2), U$18.P$1

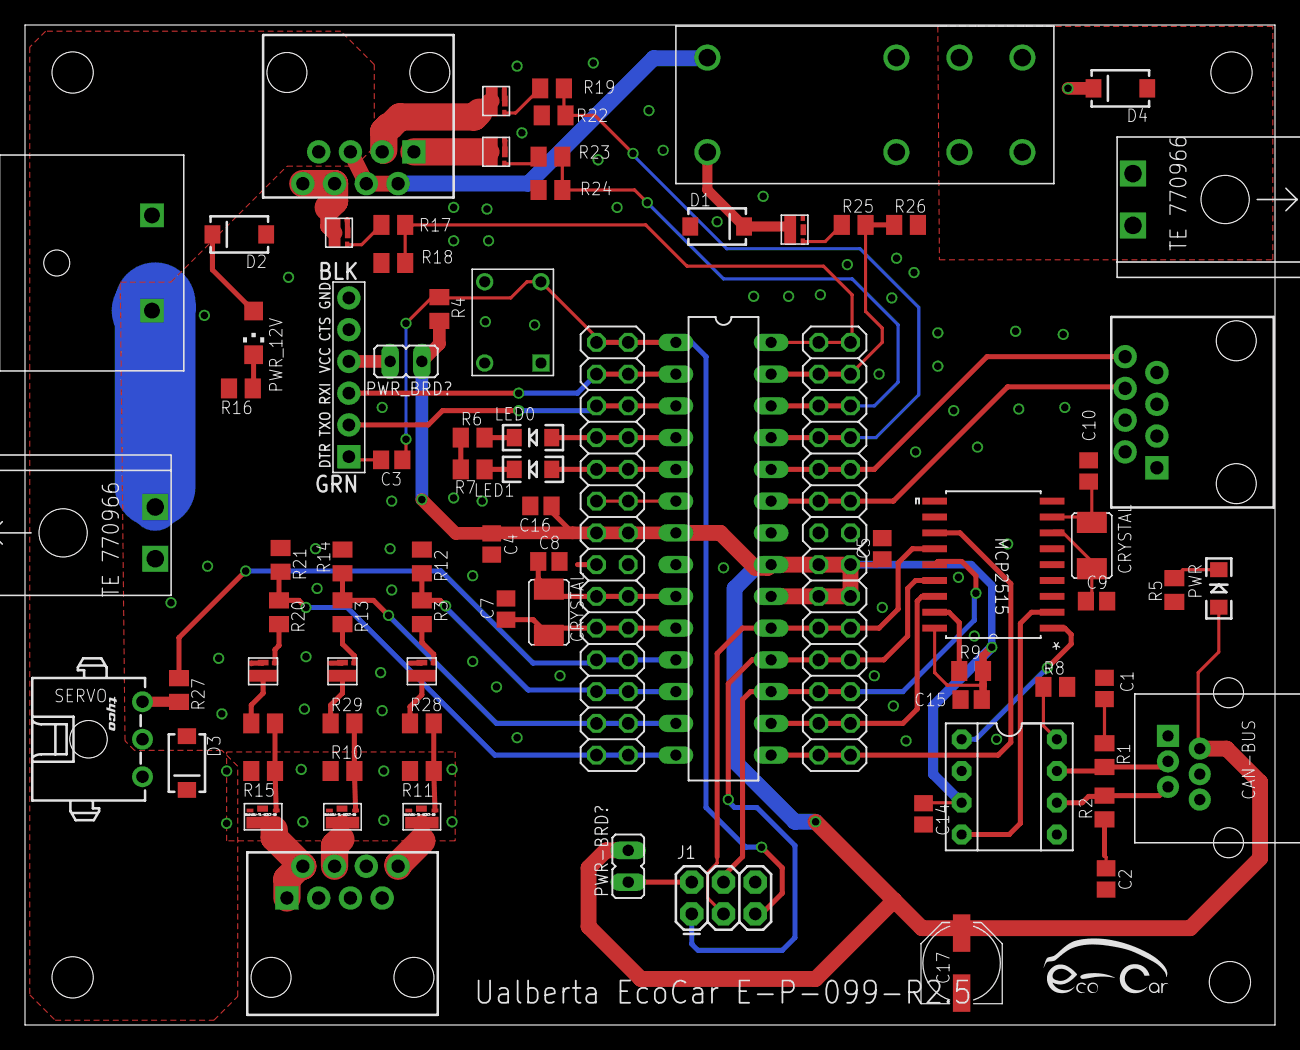
[picture p11: board E-P-099-R2.5.brd from above]

Board: 2 copper layers, 100.0 x 80.0 mm, 86 parts (0 on the bottom side), 67 nets.
