UAlberta-EcoCar/Auxiliaries-Board/(commit log)

2016-01-23 added eagle files
    [E-P-099-R2.2.brd, E-P-099-R2.2.sch]
2016-03-04 Added most recent revision
    [E-P-099-R2.2.brd, E-P-099-R2.2.sch, E-P-099-R2.5.brd, E-P-099-R2.5.sch]
2017-01-29 version 2.6
    [E-P-099-R2.5.brd, E-P-099-R2.5.sch, E-P-099-R2.6.brd, E-P-099-R2.6.sch, connector.brd, connector.sch]
2017-09-17 design fixes
    added LED's to all signals and fixed up some layout issues
    [E-P-099-R2.7.brd, E-P-099-R2.7.sch]
2017-09-17 removed old version
    deleted R2.6 for R2.7
    [E-P-099-R2.6.brd, E-P-099-R2.6.sch]
2017-09-17 archived 2.6
    I forgot to do this before making changes.. really just here for posterity sake.
    [E-P-099-R2.6.brd, E-P-099-R2.6.sch]
2017-10-02 new Aux design
    Changed 5V input from Rj11 to pin connector, changed servo power to 5V onboard. cleaned up routing and silkscreen for easier soldering. needs new logo.
    [E-P-099-R2.7.brd, E-P-099-R2.7.sch, E-P-099-R2.8.brd, E-P-099-R2.8.sch]
2017-10-10 Gerbers Generated
    [E-P-099-R2.8.GBL, E-P-099-R2.8.GBO, E-P-099-R2.8.GBP, E-P-099-R2.8.GBS, E-P-099-R2.8.GTL, E-P-099-R2.8.GTO, E-P-099-R2.8.GTP, E-P-099-R2.8.GTS]
2017-10-16 pinouts updated to match new light boards
    New changes to the pinouts for the ethernet connectors to match the new design of the head and tail light boards. Also designed to be symmetric across the connector to prevent mistakes.
    [E-P-099-R2.8.brd, E-P-099-R2.8.sch]
2017-11-25 Revert "pinouts updated to match new light boards"
    This reverts commit c6705fe930e627c4a8d5c034fe7450b97c4f4bb6.
    [E-P-099-R2.8.brd, E-P-099-R2.8.sch]
2017-11-27 Deleted Gerbers and added horn board
    [E-P-099-R2.8.GBL, E-P-099-R2.8.GBO, E-P-099-R2.8.GBP, E-P-099-R2.8.GBS, E-P-099-R2.8.GTL, E-P-099-R2.8.GTO, E-P-099-R2.8.GTP, E-P-099-R2.8.GTS]
2017-11-27 Added Connectors to horn board
    [Horn Board.brd, Horn Board.sch]
2017-12-03 Uploading new revision
    [Horn Board Rev 1.brd, Horn Board Rev 1.sch]
2018-05-06 VER.3
    Added through hole mosfets, fixed input switch logic, improved pull downs on inout, added connector for break switch, increased board size and fixed routing,
    [E-P-099-R2.8.brd, E-P-099-R2.8.sch]
2018-05-13 added pull down resistors to switches, added windshield wiper switch, added capacitors to make mike happy, adjusted led circuit on outputs might need different resistor values, changed a couple other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
    [E-P-099-R2.8.brd, E-P-099-R2.8.sch]
2018-05-23 added separate power for servo, cleaned up a bit of board layout, remade some missing eagle libraries and added them to library repo
    [E-P-099-R2.8.brd, E-P-099-R2.8.sch, E-P-099-R3.0.brd, E-P-099-R3.0.sch]
2018-05-23 added silk screen labels to some parts. moved back to coordinate system origin
    [E-P-099-R3.0.brd, E-P-099-R3.0.sch]
2018-05-29 took some signals off of steering wheel and put on new ethernet
    [E-P-099-R3.0.brd, E-P-099-R3.0.sch]
